yuransde/IOT-Kitchen-2020/Images/Scale_Circuit_Schematic.pdf

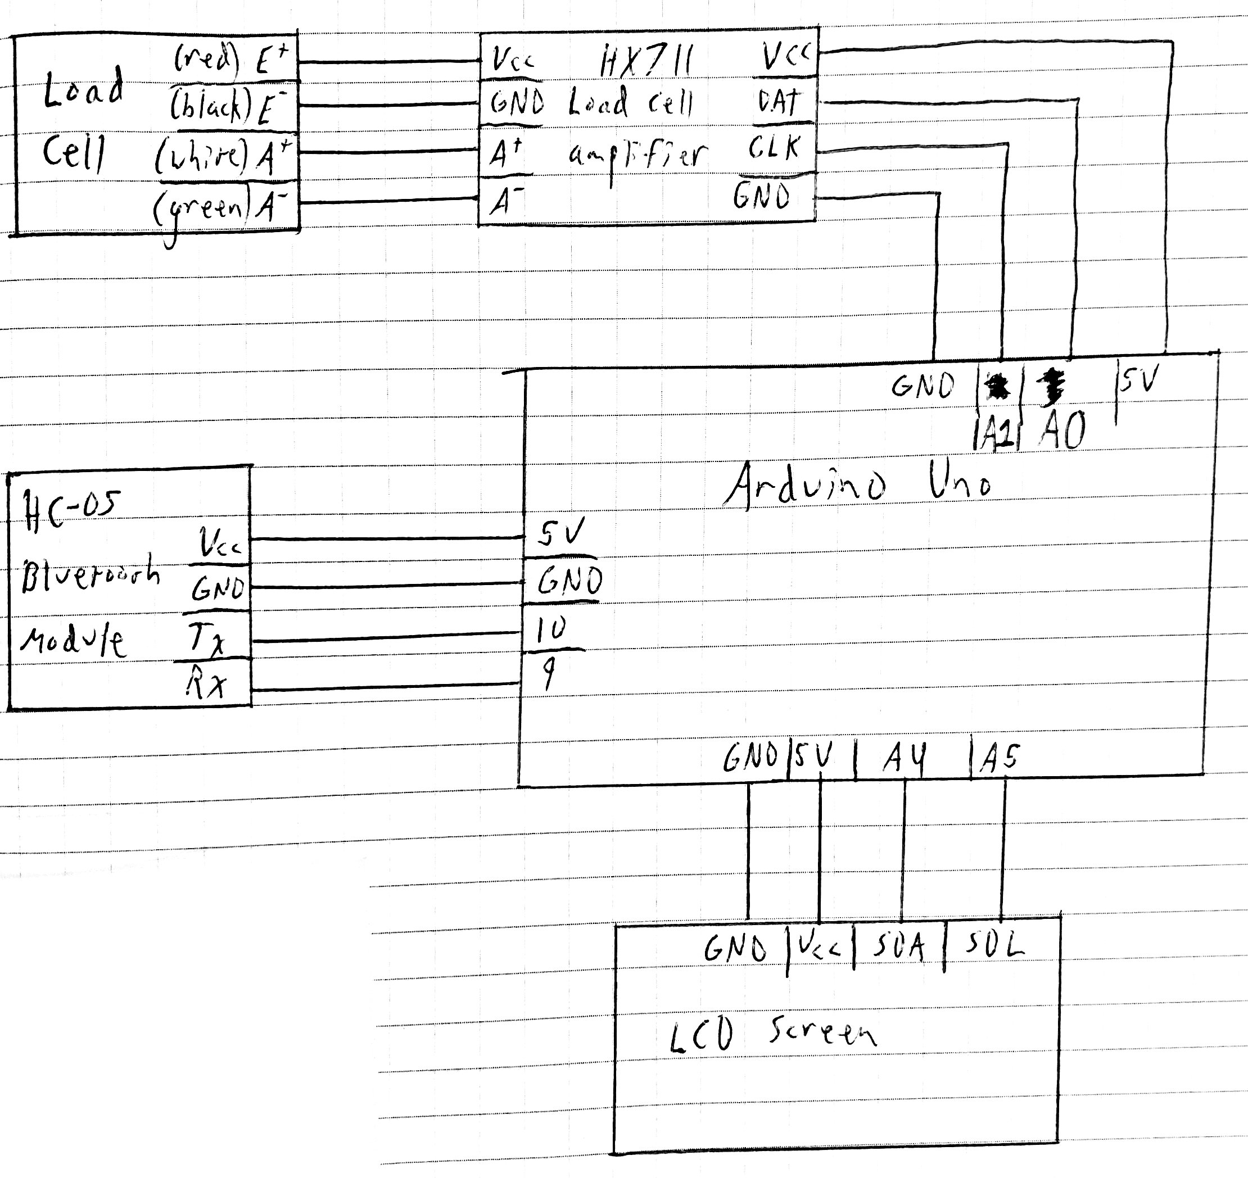
[picture p16: page 1]
