yuransde/IOT-Kitchen-2020/Images/Temp_Circuit_Schematic.pdf

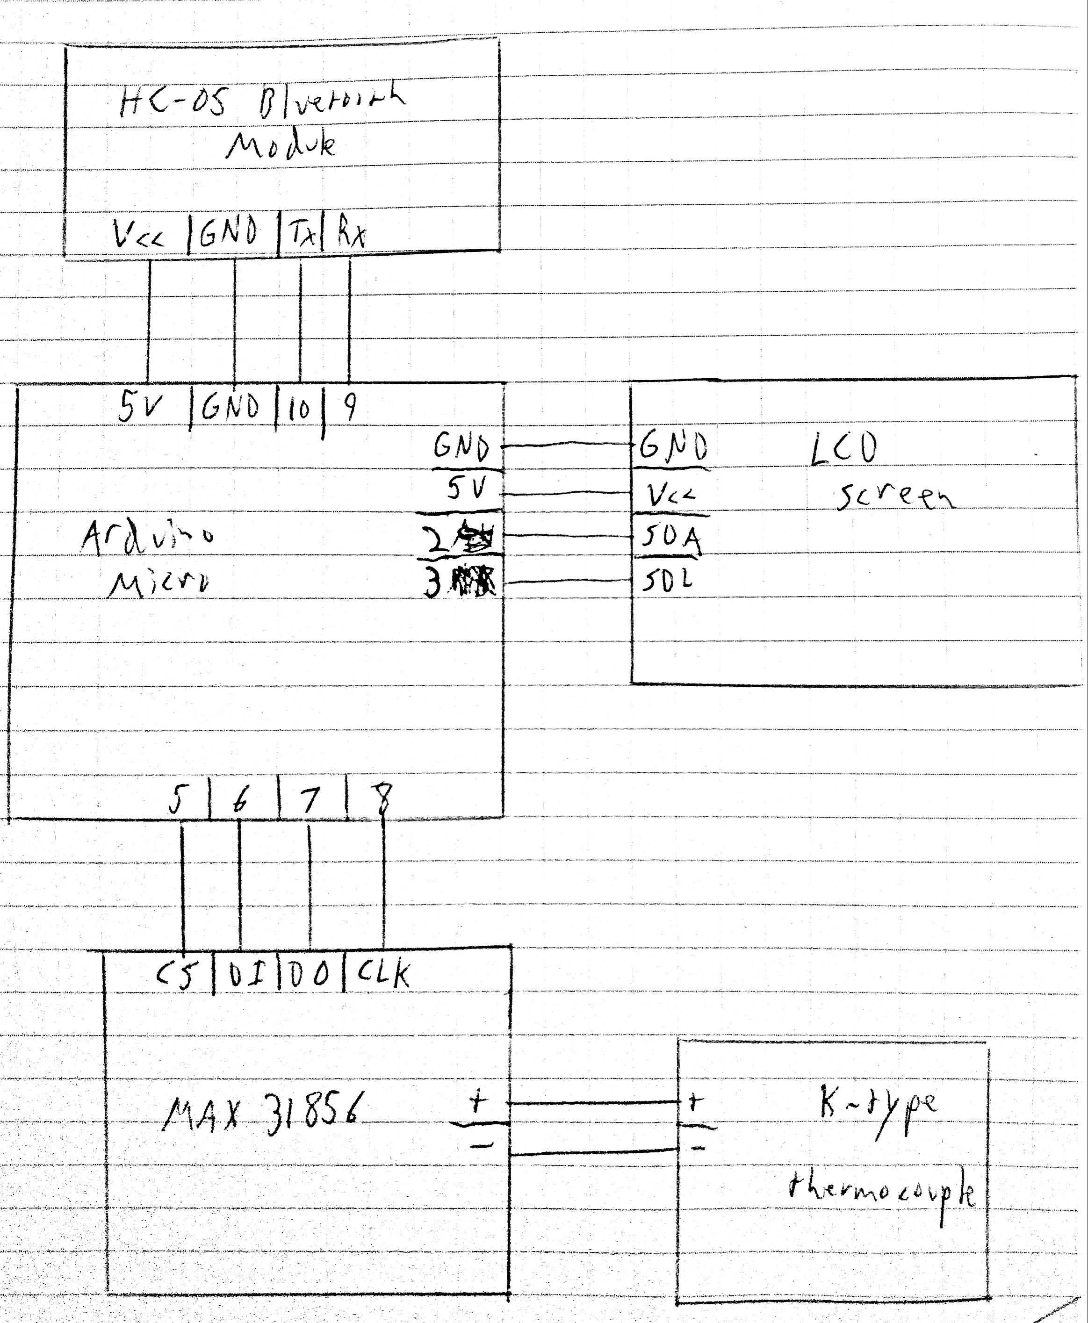
[picture p17: page 1]
